tomorrow56/M5Stack_USB_Host/README.md

# M5Stack_USB_Host

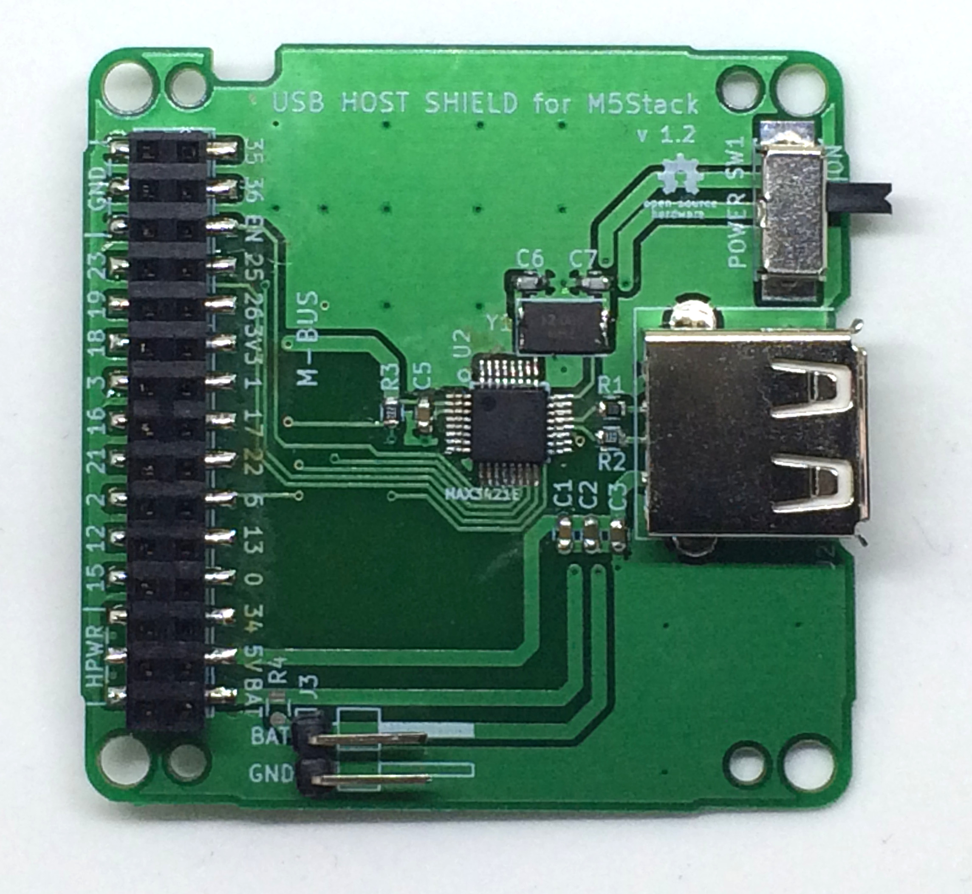
[picture p1: v1.2/M5_USB_Host_v1r2_photo.JPG]
USB Host Shield


Web site: [https://thousandiy.wordpress.com/2018/06/16/usb-host-for-m5stack/](https://thousandiy.wordpress.com/2018/06/16/usb-host-for-m5stack/)
