tomorrow56/M5Stack_USB_Host/v1.2/USB_Host_case_for_v1.2/readme.md

# USB Host shield case data for v.1.2

This is 3D print case data dedicated to the USB host shield v.1.2.
 - USBHost_8.3mm_for_v1.2.f3d : Fusion 360 format
 - USBHost_8.3mm_for_v1.2.step : STEP format
 - USBHost_8.3mm_for_v1.2.stl : stl format

This is just reference data and I tried to print this data by AFINIA H800+.
If you print this data, it is necessary to output a thin wall, so it is recommended to rotate 45 degrees as shown below and print it.
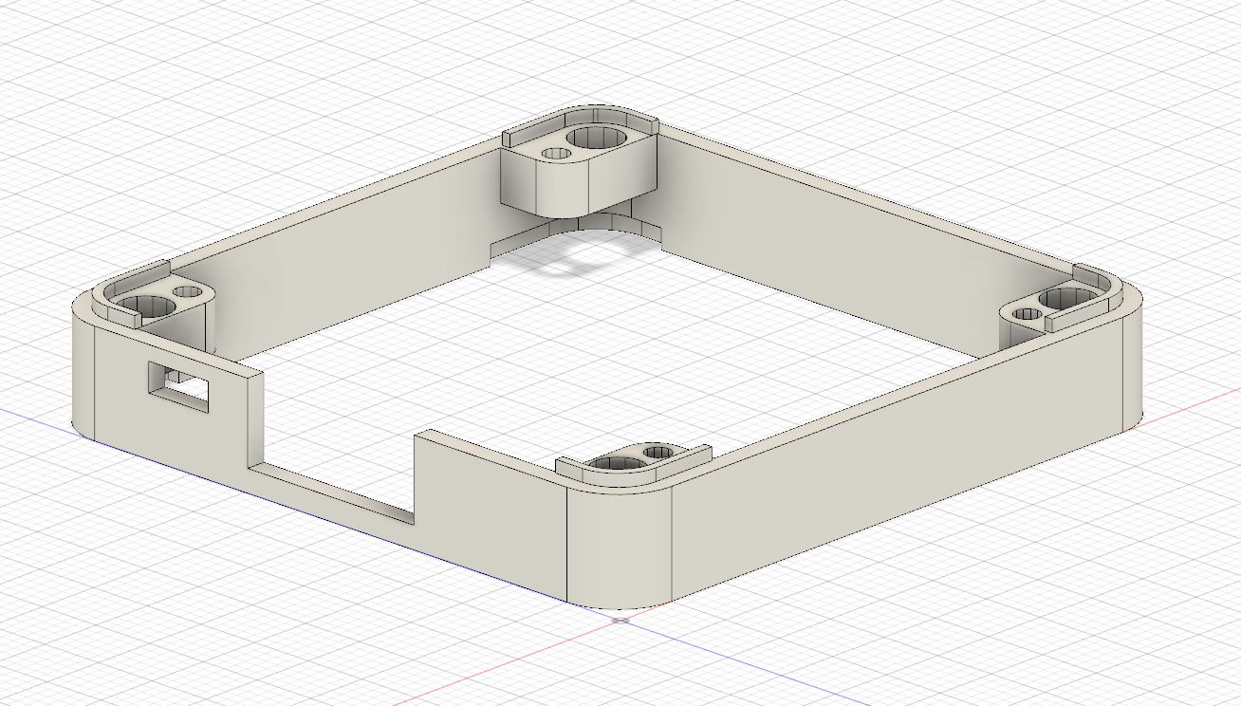
[picture p2: v1.2/USB_Host_case_for_v1.2/M5_USB_Host_case_v1r2.JPG]
USB Host case


## Start selling in DMM.make Creator's Market
 https://make.dmm.com/shop/228577
