tomorrow56/M5Stack_USB_Host/v1.2/M5_USB_Host_v1r2_board.jpg

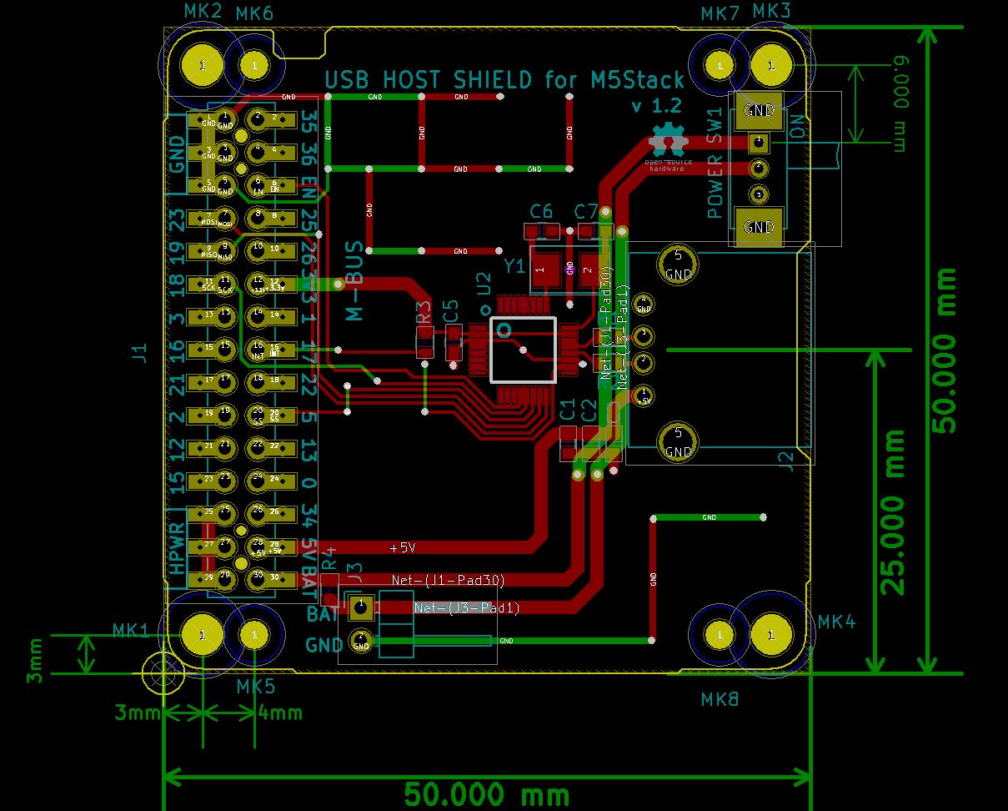
v1.2/M5_USB_Host_v1r2_board.jpg
