tomorrow56/M5Stack_USB_Host/v1.2/USB_Host_case_for_v1.2/USBHost_8.3mm_for_v1.2.step

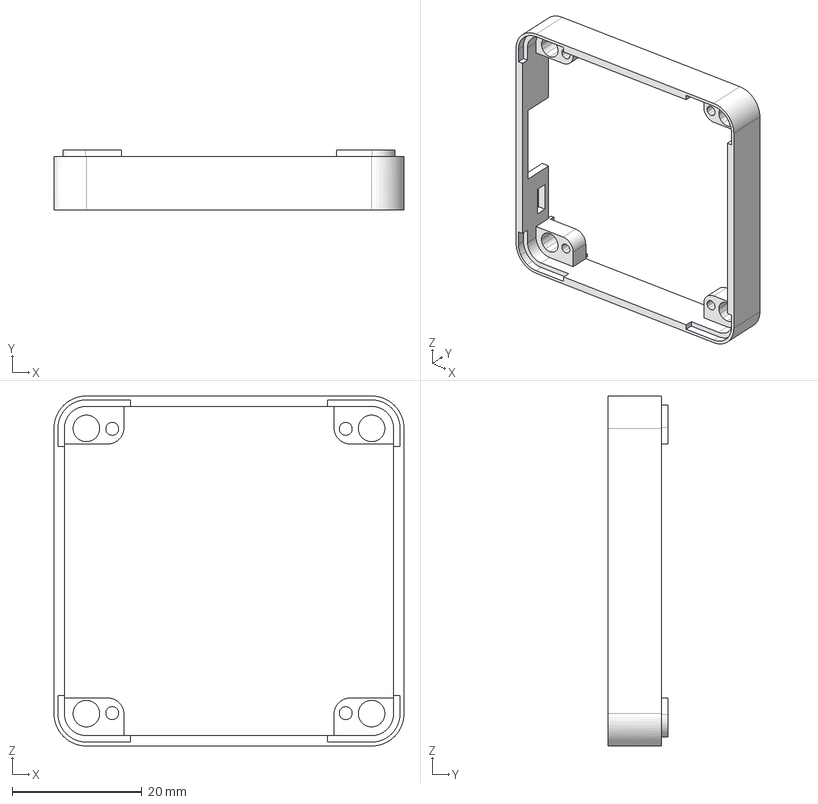
[picture p5: CAD file, 2018-10-15]
v1.2/USB_Host_case_for_v1.2/USBHost_8.3mm_for_v1.2.step
54.0 x 9.30 x 54.0 mm
