tomorrow56/M5Stack_USB_Host/v1.1/USB_Host_case_for_v1.1/USBHost_12.0mm_for_v1.1.step

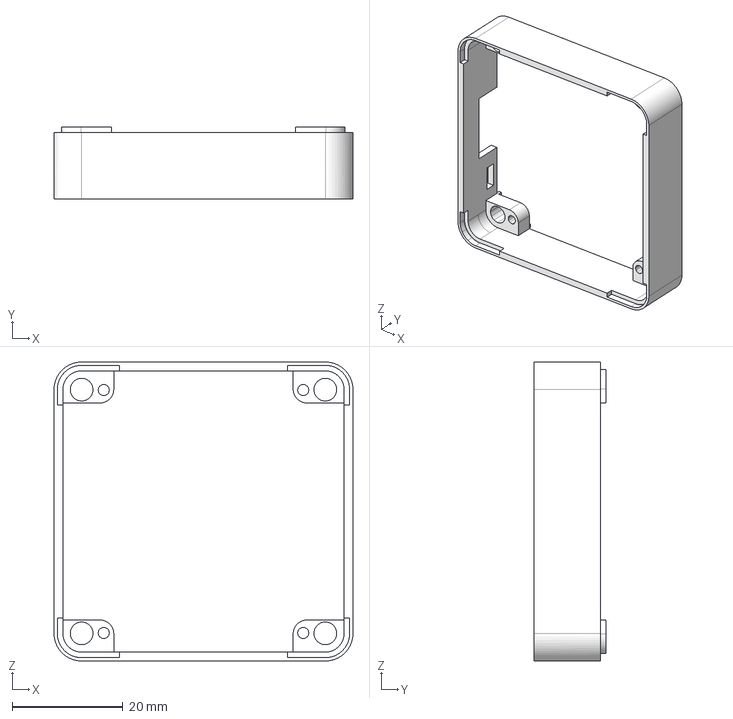
[picture p6: CAD file, 2018-10-15, an earlier design]
v1.1/USB_Host_case_for_v1.1/USBHost_12.0mm_for_v1.1.step
54.0 x 13.0 x 54.0 mm
