tomorrow56/M5Stack_USB_Host/(list of files, cad)

Other CAD files:
v1.1/USB_Host_case_for_v1.1/USBHost_12.0mm_for_v1.1.f3d
v1.1/USB_Host_case_for_v1.1/USBHost_12.0mm_for_v1.1.stl
v1.2/USB_Host_case_for_v1.2/USBHost_8.3mm_for_v1.2.f3d
v1.2/USB_Host_case_for_v1.2/USBHost_8.3mm_for_v1.2.stl
