tomorrow56/M5Stack_USB_Host/v1.1/M5_USB_Host_v1r1_schematics.pdf

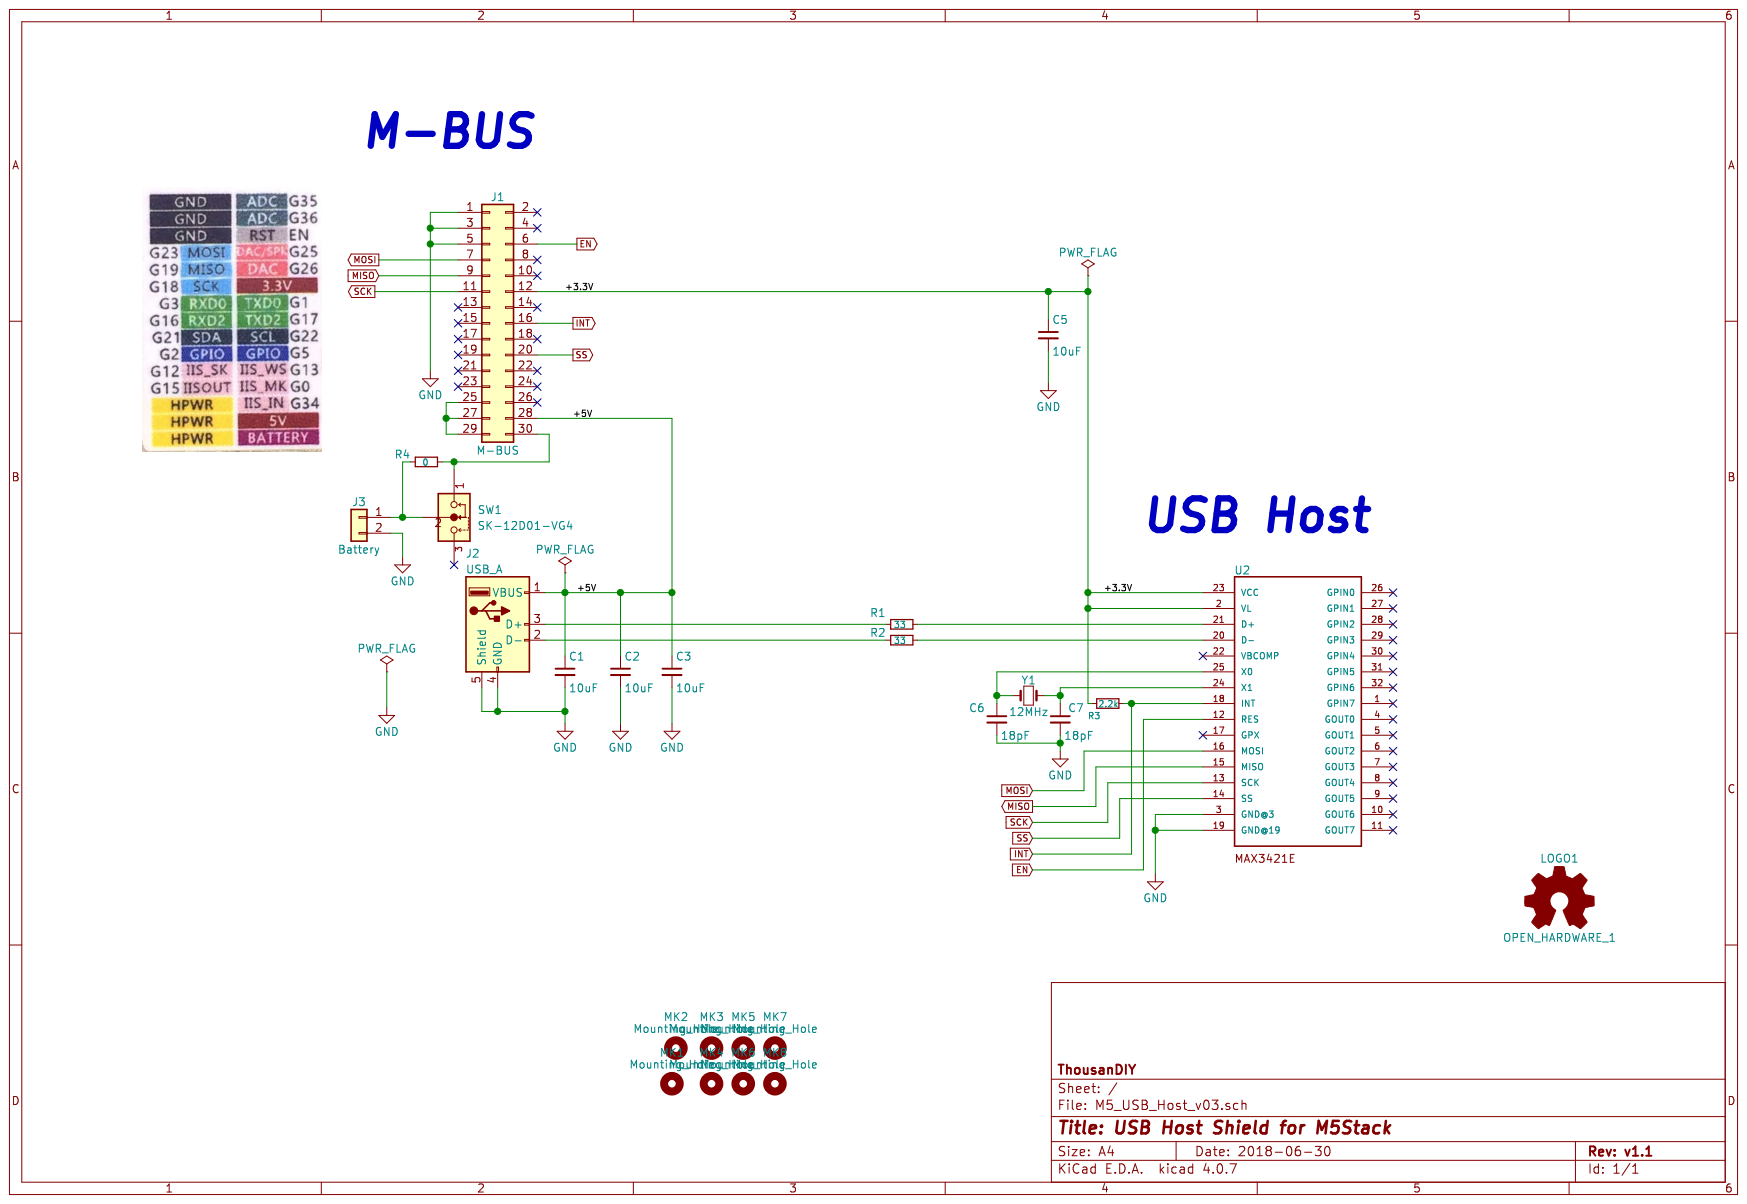
[picture p8: page 1]
