tomorrow56/M5Stack_USB_Host/v1.0/M5_USB_Host_v01_schematics.pdf

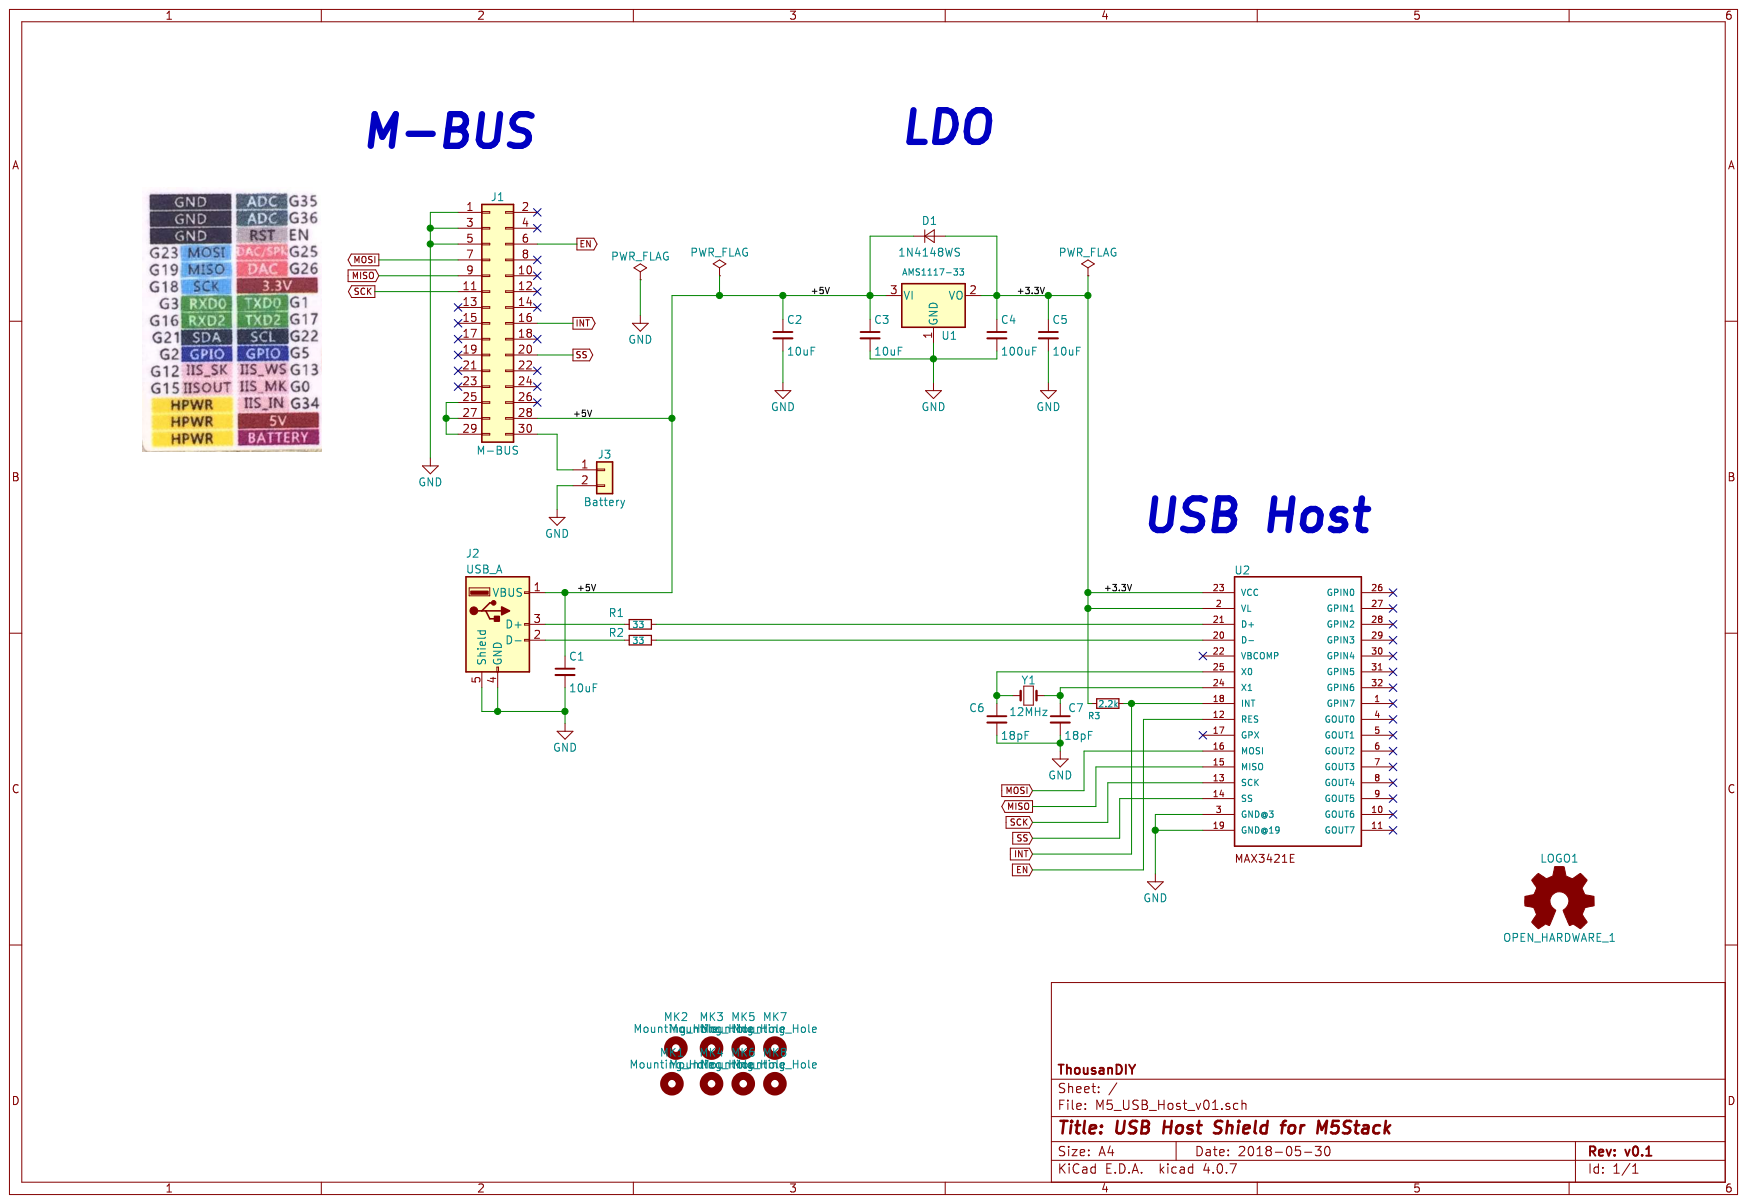
[picture p9: page 1]
