tomorrow56/M5Stack_USB_Host/v1.2/KiCad/M5_USB_Host_v04/M5_USB_Host_v04.kicad_pcb

## KiCad design v1.2/KiCad/M5_USB_Host_v04/M5_USB_Host_v04.kicad_pcb (2018-09-24)

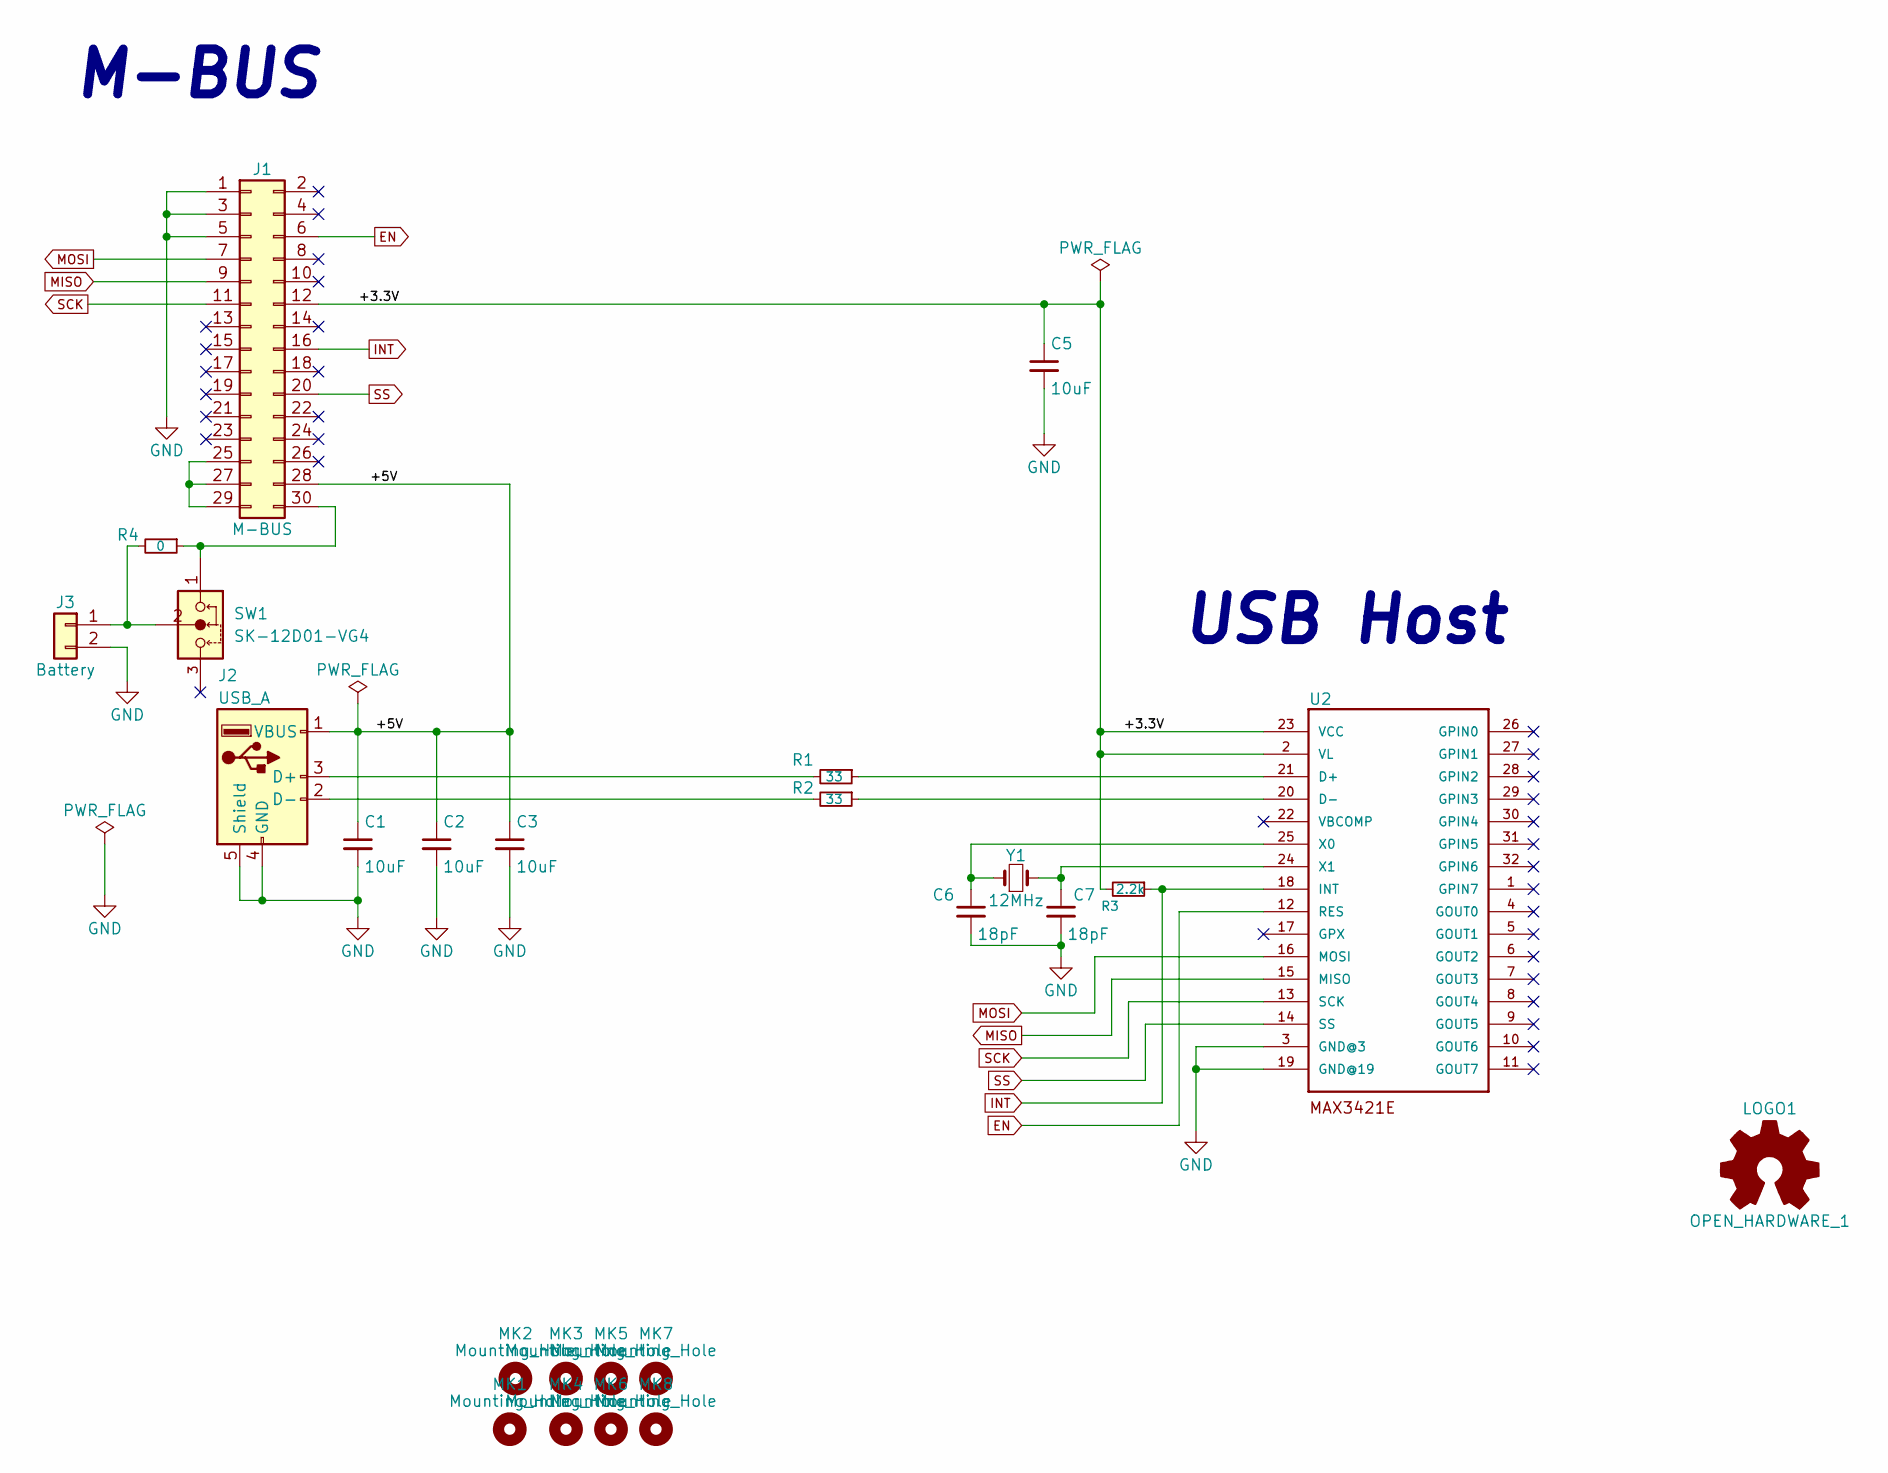
[picture p10: schematic M5_USB_Host_v04.sch, USB Host Shield for M5Stack]

Parts:
C1, C2, C3, C5: 10uF; C_0603
C6, C7: 18pF; C_0603
J1: M-BUS; Pin_Header_MBUS_SMD_TH
J2: USB_A
J3: Battery; Pin_Header_Angled_1x02_Pitch2.54mm
LOGO1: OPEN_HARDWARE_1; OSHW-logo_silkscreen-front_3mm
MK1, MK2, MK3, MK4: Mounting_Hole; MountingHole_3.2mm_M3
MK5, MK6, MK7, MK8: Mounting_Hole; MountingHole_2.2mm_M2
R1, R2: 33; R_0603
R3: 2.2k; R_0603
R4: 0; R_0603
SW1: SK-12D01-VG4; slide_switch_angled
U2: MAX3421E; MAX3421E_TQFP32-5MM
Y1: 12MHz; Crystal_SMD_5032-2pin_5.0x3.2mm

Connections:
/+3.3V: C5.1, J1.12, R3.2, U2.2 (VL), U2.23 (VCC)
/+5V: C1.1, C2.1, C3.1, J1.28, J2.1 (VBUS)
EN: J1.6, U2.12 (RES)
GND: C1.2, C2.2, C3.2, C5.2, C6.2, C7.2, J1.1, J1.3, J1.5, J2.4 (GND), J2.5 (Shield), J3.2, U2.3 (GND@3), U2.19 (GND@19)
INT: J1.16, R3.1, U2.18 (INT)
MISO: J1.9, U2.15 (MISO)
MOSI: J1.7, U2.16 (MOSI)
unnamed: C6.1, U2.25 (X0), Y1.1
unnamed: C7.1, U2.24 (X1), Y1.2
unnamed: J1.25, J1.27, J1.29
unnamed: J1.30, R4.1, SW1.1
unnamed: J2.2 (D-), R2.2
unnamed: J2.3 (D+), R1.2
unnamed: J3.1, R4.2, SW1.2
unnamed: R1.1, U2.21 (D+)
unnamed: R2.1, U2.20 (D-)
SCK: J1.11, U2.13 (SCK)
SS: J1.20, U2.14 (SS)

Notes on the sheet:
M-BUS
USB Host

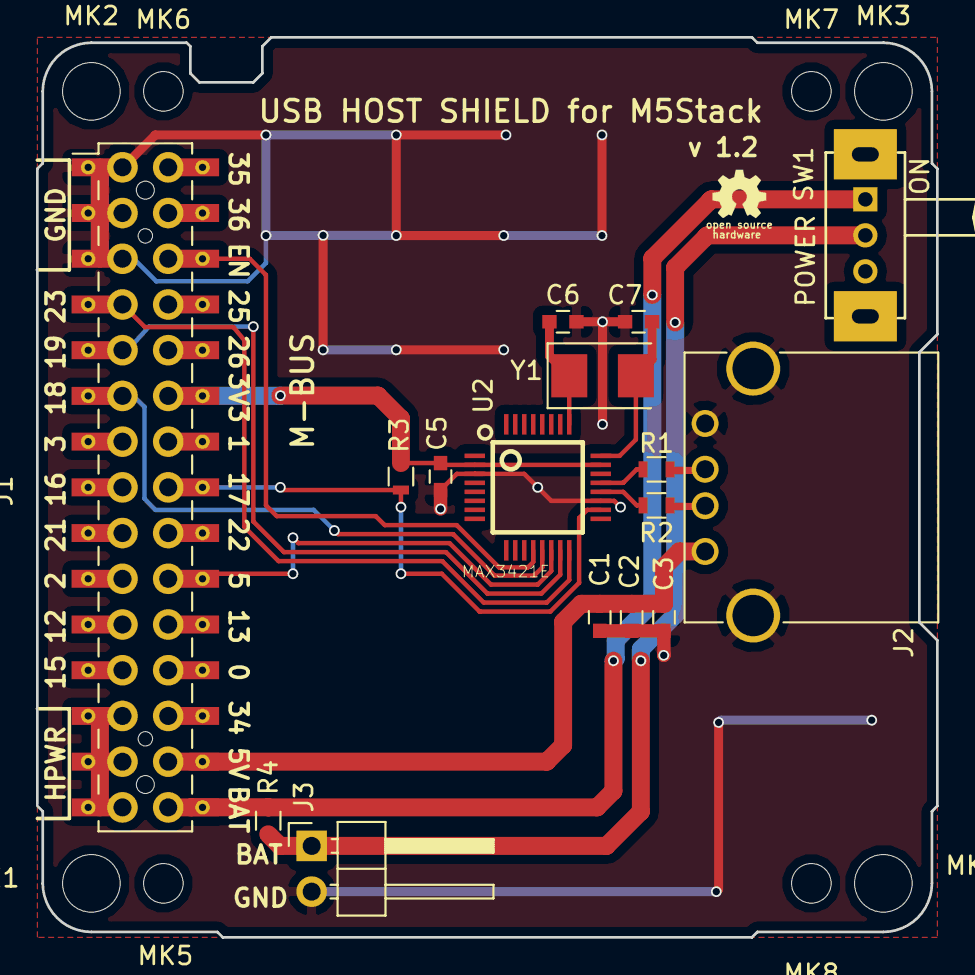
[picture p11: board M5_USB_Host_v04.kicad_pcb from above]

Board: 2 copper layers, 50.0 x 50.0 mm, 25 parts (0 on the bottom side), 18 nets.
