tomorrow56/M5Stack_USB_Host/(commit log)

2018-07-13 Nt Kanazawa 2018 version
    [M5_USB_Host_v01.kicad_pcb, M5_USB_Host_v01.sch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]
2018-09-24 add v1.2 for Switch Science
    [M5_USB_Host_v04.kicad_pcb, M5_USB_Host_v04.sch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]
2018-10-15 add Host shield case data
    [USBHost_12.0mm_for_v1.1.f3d, USBHost_12.0mm_for_v1.1.step, USBHost_12.0mm_for_v1.1.stl]
